m0tei/PressureTaps/mechanical/alt_press_fit/alt_closed_tube_side.png

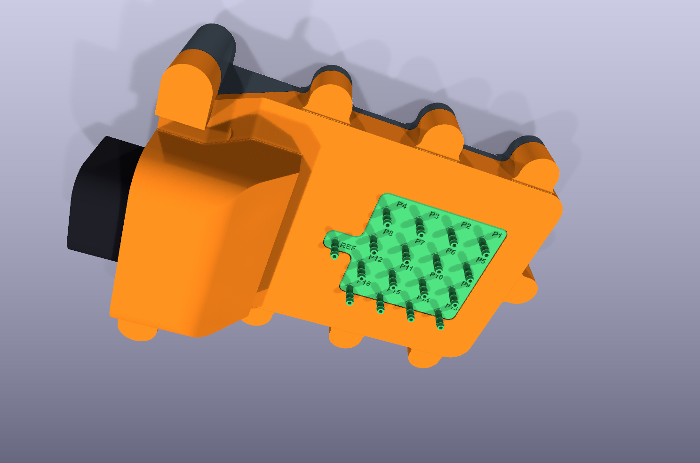
mechanical/alt_press_fit/alt_closed_tube_side.png
