m0tei/PressureTaps/mechanical/alt_press_fit/alt_module_top.png

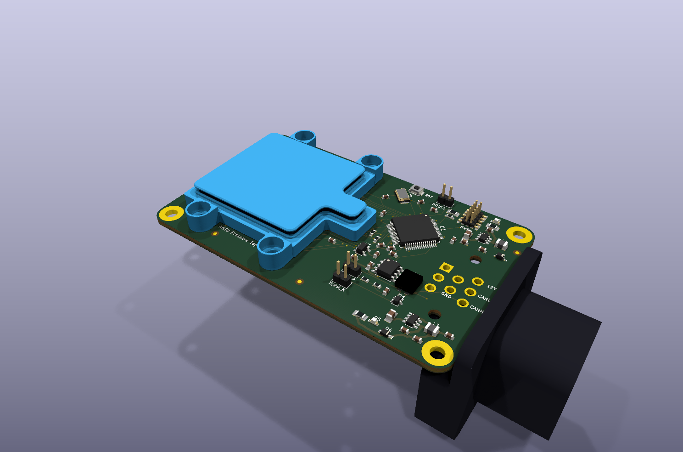
mechanical/alt_press_fit/alt_module_top.png
