m0tei/PressureTaps/mechanical/alt_press_fit/alt_closed.png

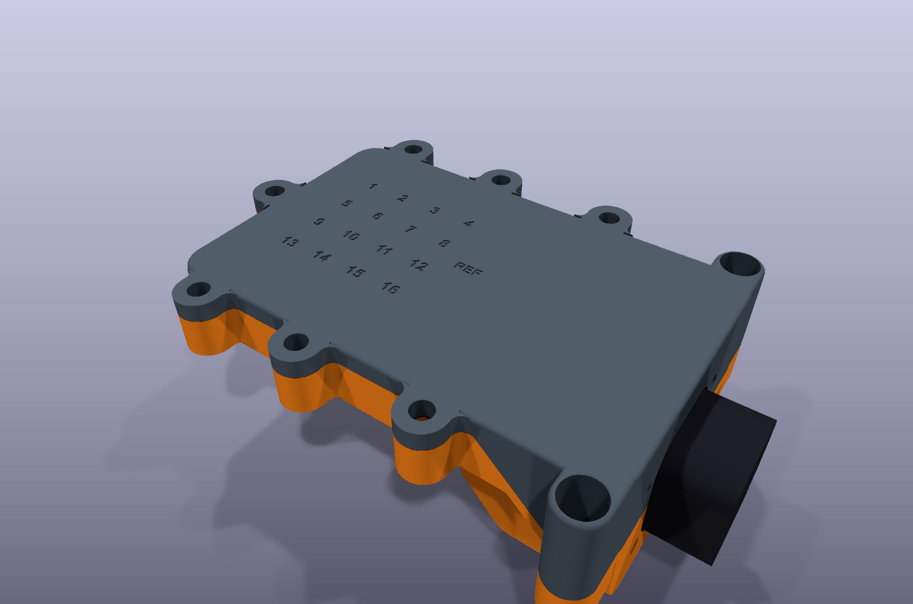
mechanical/alt_press_fit/alt_closed.png
