m0tei/PressureTaps/mechanical/alt_press_fit/alt_exploded.png

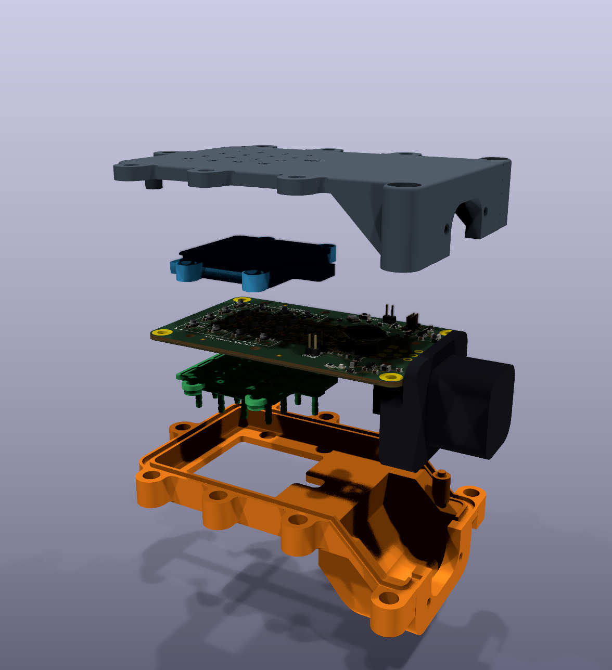
mechanical/alt_press_fit/alt_exploded.png
