m0tei/PressureTaps/mechanical/alt_press_fit/alt_exploded_underside.png

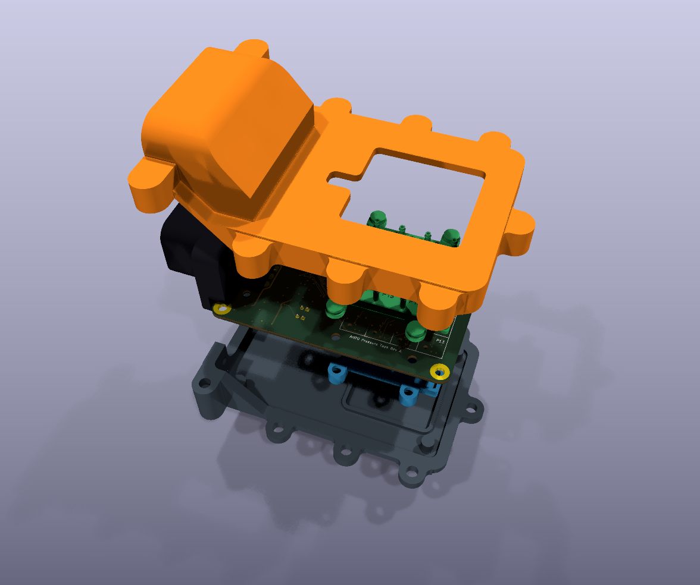
mechanical/alt_press_fit/alt_exploded_underside.png
