m0tei/PressureTaps/mechanical/alt_press_fit/alt_module_back.png

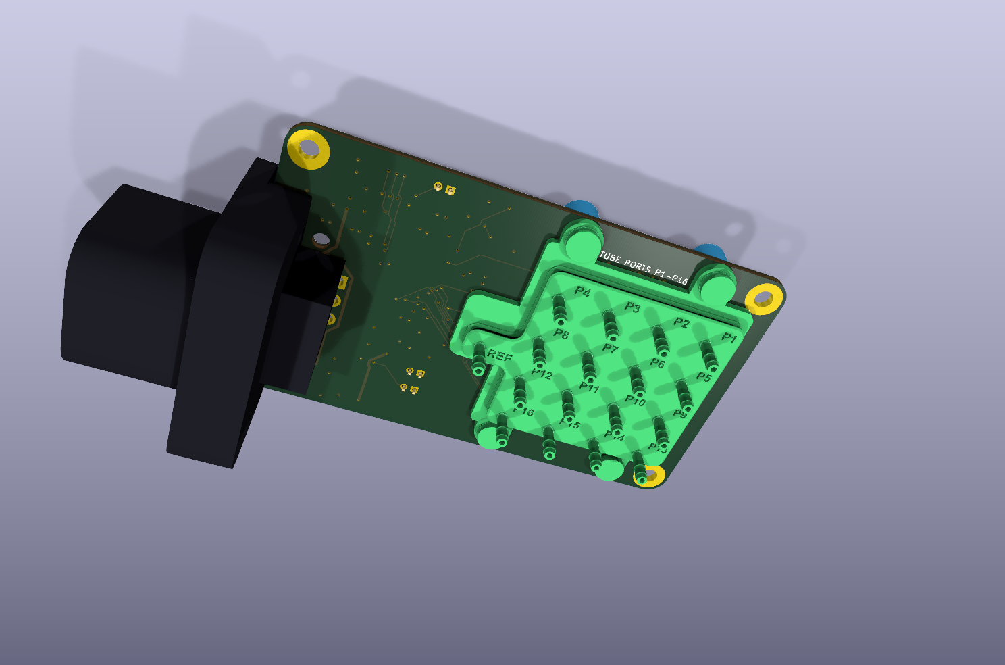
mechanical/alt_press_fit/alt_module_back.png
