m0tei/PressureTaps/mechanical/alt_press_fit/PressureTaps_Sensor_Cover.step

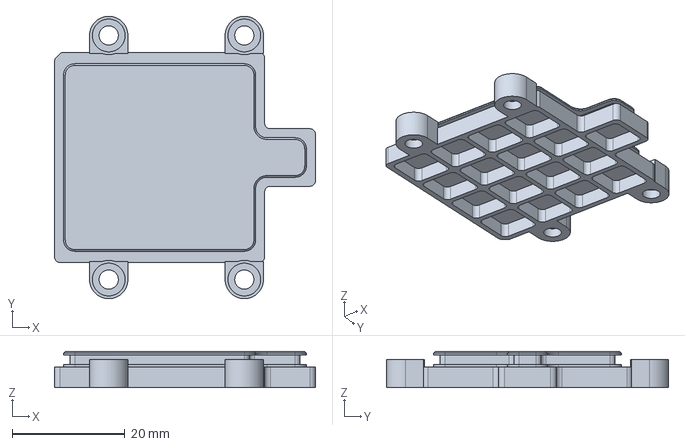
[picture p7: CAD file, 2026-11-06]
mechanical/alt_press_fit/PressureTaps_Sensor_Cover.step
46.2 x 50.0 x 6.40 mm
