m0tei/PressureTaps/mechanical/alt_press_fit/PressureTaps_Tube_Block.step

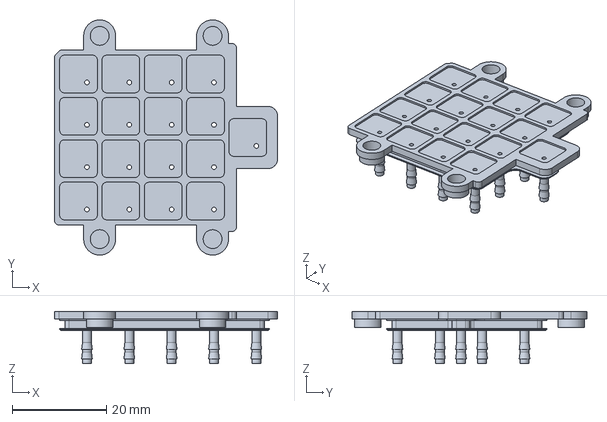
[picture p8: CAD file, 2026-11-06]
mechanical/alt_press_fit/PressureTaps_Tube_Block.step
47.4 x 50.0 x 11.1 mm
