m0tei/PressureTaps/mechanical/alt_press_fit/PressureTaps_Case_Bottom.step

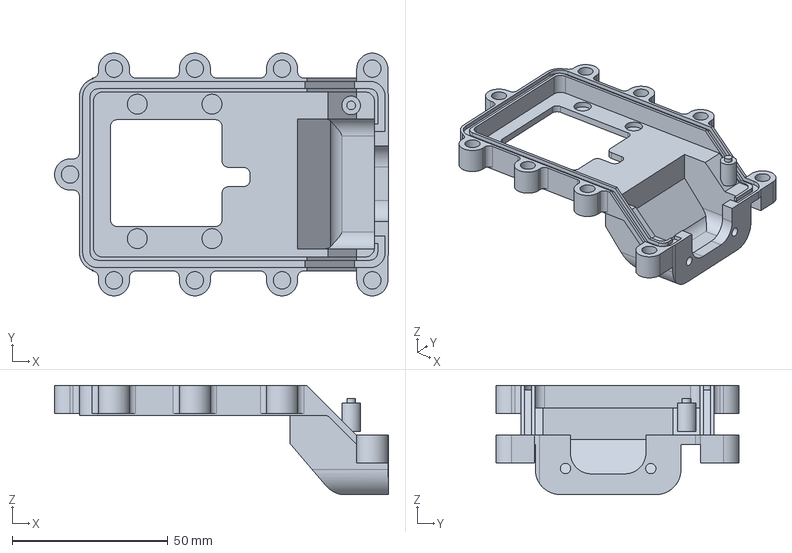
[picture p9: CAD file, 2026-11-06]
mechanical/alt_press_fit/PressureTaps_Case_Bottom.step
107.3 x 78.0 x 35.0 mm
