m0tei/PressureTaps/mechanical/alt_press_fit/PressureTaps_Case_Top.step

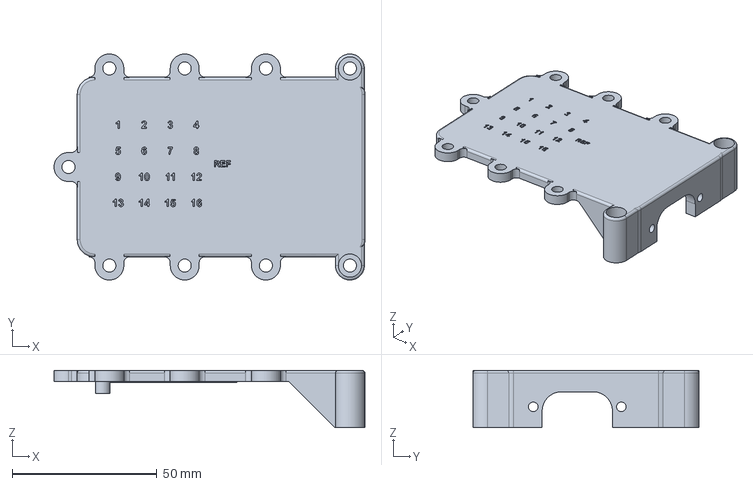
[picture p10: CAD file, 2026-11-06]
mechanical/alt_press_fit/PressureTaps_Case_Top.step
107.3 x 78.0 x 19.8 mm
