m0tei/PressureTaps/(list of files, cad)

Other CAD files:
mechanical/alt_press_fit/PressureTaps_Case_Bottom.stl
mechanical/alt_press_fit/PressureTaps_Case_Top.stl
mechanical/alt_press_fit/PressureTaps_Sensor_Cover.stl
mechanical/alt_press_fit/PressureTaps_Tube_Block.stl
