m0tei/PressureTaps/PressureTaps.kicad_pcb

## KiCad design PressureTaps.kicad_pcb (2026-11-06)

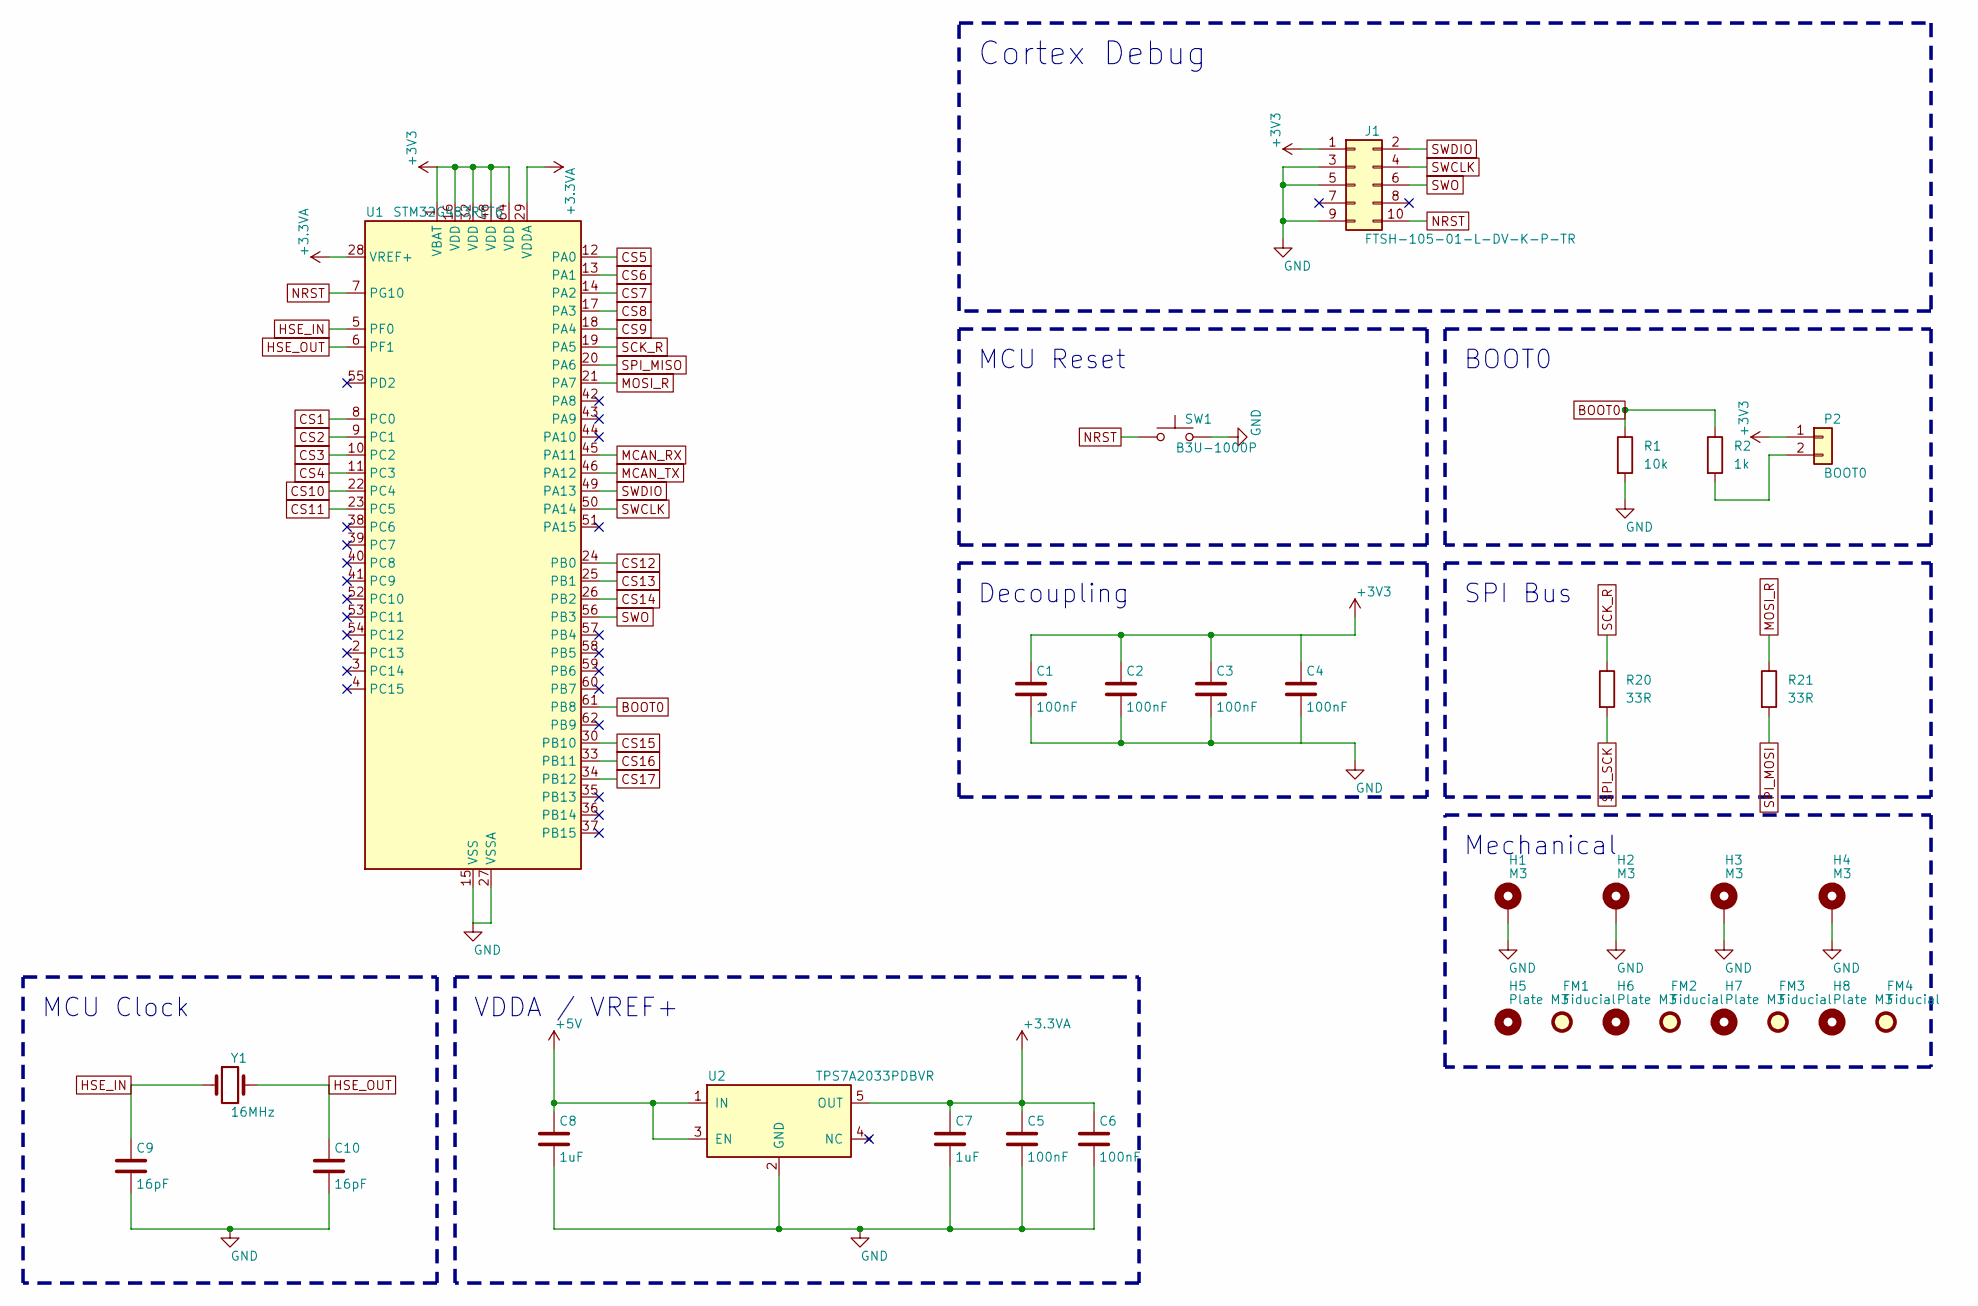
[picture p11: schematic MCU.kicad_sch]

Parts:
C1, C2, C3, C4, C5, C6: 100nF; GW_C1; MPN CC0603JRX7R9BB104
C7, C8: 1uF; GW_C7; MPN CC0603KRX5R8BB105
C9, C10: 16pF; GW_C9; MPN C0603C160J5HACTU
FM1, FM2, FM3, FM4: Fiducial; Fiducial_1mm_Mask2mm
H1, H2, H3, H4: M3; MountingHole_3.2mm_M3_Pad
H5, H6, H7, H8: Plate M3; MountingHole_3.2mm_M3
J1: FTSH-105-01-L-DV-K-P-TR; GW_J1; MPN FTSH-105-01-L-DV-K-P-TR
P2: BOOT0; PinHeader_1x02_P2.00mm_Vertical; MPN 62000211121
R1: 10k; GW_R1; MPN AF0603FR-0710KL
R2: 1k; GW_R2; MPN ERJ-6ENF1001V
R20, R21: 33R; GW_R1
SW1: B3U-1000P; SW_SPST_B3U-1000P; MPN B3U-1000P
U1: STM32G483RET6; LQFP-64_10x10mm_P0.5mm; MPN STM32G483RET6
U2: TPS7A2033PDBVR; SOT-23-5; MPN TPS7A2033PDBVR
Y1: 16MHz; GW_Y1; MPN ABM3-16.000MHZ-D2Y-T

Connections:
+3.3VA: C5.1, C6.1, C7.1, U1.28 (VREF+), U1.29 (VDDA), U2.5 (OUT)
+3V3: C1.1, C2.1, C3.1, C4.1, J1.1, P2.1, U1.1 (VBAT), U1.16 (VDD), U1.32 (VDD), U1.48 (VDD), U1.64 (VDD); also elsewhere on the board
+5V: C8.1, U2.1 (IN), U2.3 (EN); also elsewhere on the board
BOOT0: R1.1, R2.1, U1.61 (PB8)
CS1: U1.8 (PC0); also elsewhere on the board
CS2: U1.9 (PC1); also elsewhere on the board
CS3: U1.10 (PC2); also elsewhere on the board
CS4: U1.11 (PC3); also elsewhere on the board
CS5: U1.12 (PA0); also elsewhere on the board
CS6: U1.13 (PA1); also elsewhere on the board
CS7: U1.14 (PA2); also elsewhere on the board
CS8: U1.17 (PA3); also elsewhere on the board
CS9: U1.18 (PA4); also elsewhere on the board
CS10: U1.22 (PC4); also elsewhere on the board
CS11: U1.23 (PC5); also elsewhere on the board
CS12: U1.24 (PB0); also elsewhere on the board
CS13: U1.25 (PB1); also elsewhere on the board
CS14: U1.26 (PB2); also elsewhere on the board
CS15: U1.30 (PB10); also elsewhere on the board
CS16: U1.33 (PB11); also elsewhere on the board
CS17: U1.34 (PB12); also elsewhere on the board
GND: C1.2, C2.2, C3.2, C4.2, C5.2, C6.2, C7.2, C8.2, C9.2, C10.2, H1.1, H2.1, H3.1, H4.1, J1.3, J1.5, J1.9, R1.2, SW1.2, U1.15 (VSS), U1.27 (VSSA), U1.31 (VSS), U1.47 (VSS), U1.63 (VSS), U2.2 (GND); also elsewhere on the board
HSE_IN: C9.1, U1.5 (PF0), Y1.1
HSE_OUT: C10.1, U1.6 (PF1), Y1.2
MCAN_RX: U1.45 (PA11); also elsewhere on the board
MCAN_TX: U1.46 (PA12); also elsewhere on the board
MOSI_R: R21.1, U1.21 (PA7)
NRST: J1.10, SW1.1, U1.7 (PG10)
unnamed: P2.2, R2.2
SCK_R: R20.1, U1.19 (PA5)
SPI_MISO: U1.20 (PA6); also elsewhere on the board
SPI_MOSI: R21.2; also elsewhere on the board
SPI_SCK: R20.2; also elsewhere on the board
SWCLK: J1.4, U1.50 (PA14)
SWDIO: J1.2, U1.49 (PA13)
SWO: J1.6, U1.56 (PB3)

Notes on the sheet:
Cortex Debug
MCU Reset
BOOT0
Decoupling
SPI Bus
MCU Clock
VDDA / VREF+
Mechanical

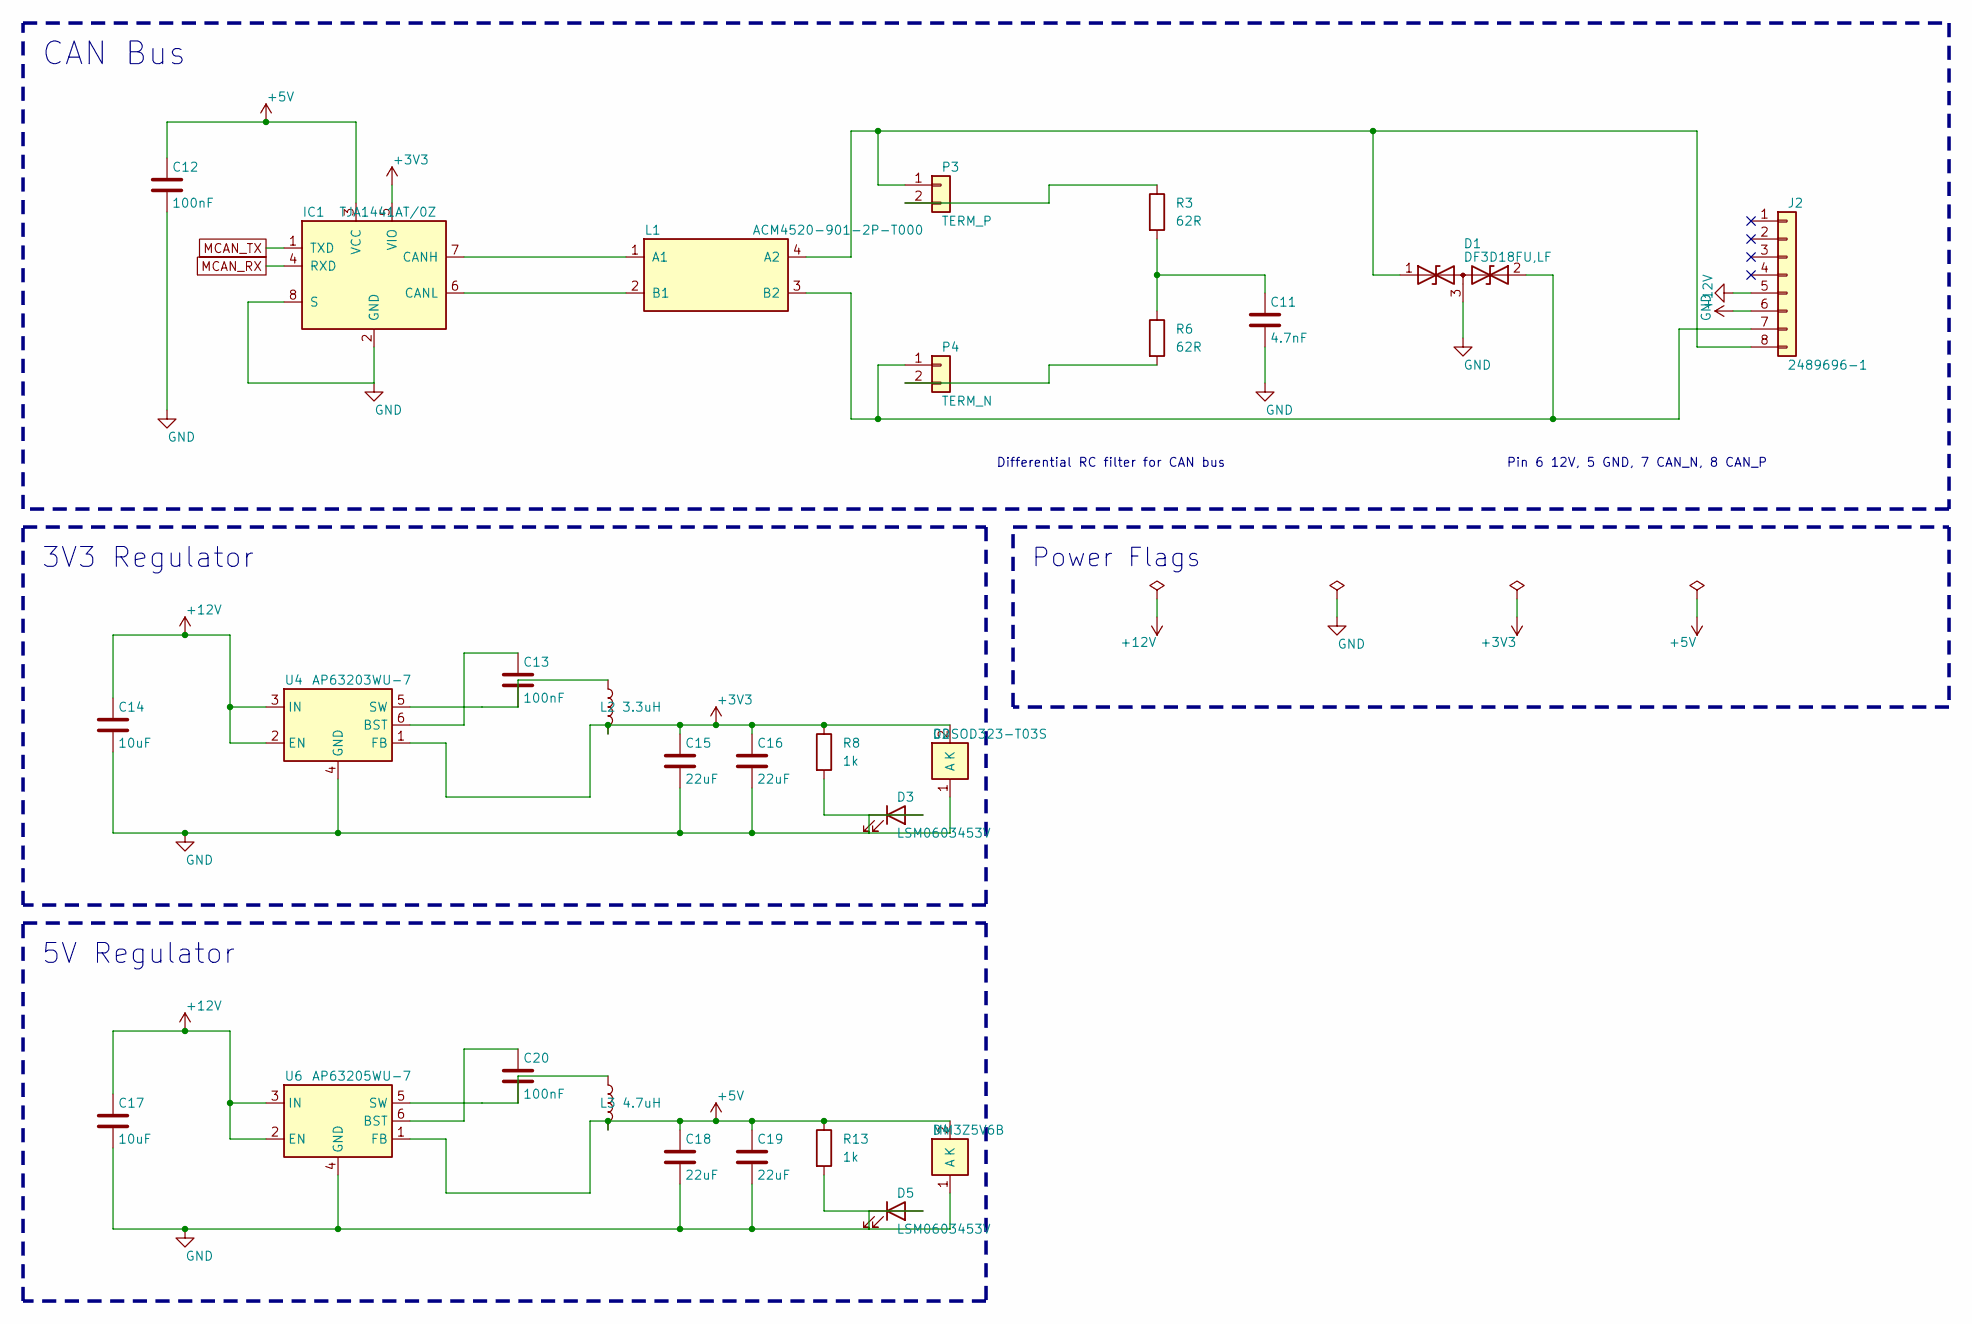
[picture p12: schematic Power_CAN.kicad_sch, Power + CAN]

Parts:
C11: 4.7nF; GW_C11; MPN C0603C472J5RACTU
C12: 100nF; GW_C12; MPN CC0603JRX7R9BB104
C13, C20: 100nF; GW_C7; MPN CC0603KRX7R8BB104
C14, C17: 10uF; GW_C14; MPN CL21A106KAYNNNE
C15, C16, C18, C19: 22uF; GW_C15; MPN GRM188R61A226ME15D
D1: DF3D18FU,LF; SOT-323_SC-70; MPN DF3D18FU,LF
D2: CDSOD323-T03S; GW_D2; MPN CDSOD323-T03S
D3, D5: LSM0603453V; GW_D3; MPN LSM0603453V
D4: MM3Z5V6B; GW_D4; MPN MM3Z5V6B
IC1: TJA1441AT/0Z; SOIC-8_3.9x4.9mm_P1.27mm; MPN TJA1441AT/0Z
J2: 2489696-1; Ampseal_8P_90deg; MPN 2489696-1
L1: ACM4520-901-2P-T000; L_ACM4520; MPN ACM4520-901-2P-T000
L2: 3.3uH; GW_L2; MPN DFE252012P-3R3M=P2
L3: 4.7uH; GW_L3; MPN DFE252012F-4R7M=P2
P3: TERM_P; PinHeader_1x02_P2.00mm_Vertical; MPN 62000211121
P4: TERM_N; PinHeader_1x02_P2.00mm_Vertical; MPN 62000211121
R3, R6: 62R; GW_R3; MPN ERA3AEB620V
R8, R13: 1k; GW_R8; MPN ERJ-6ENF1001V
U4: AP63203WU-7; TSOT-23-6; MPN AP63203WU-7
U6: AP63205WU-7; TSOT-23-6; MPN AP63205WU-7

Connections:
+3V3: C15.1, C16.1, D2.2 (K), IC1.5 (VIO), L2.2, R8.1, U4.1 (FB); also elsewhere on the board
+5V: C12.1, C18.1, C19.1, D4.2 (K), IC1.3 (VCC), L3.2, R13.1, U6.1 (FB); also elsewhere on the board
+12V: C14.1, C17.1, J2.6, U4.2 (EN), U4.3 (IN), U6.2 (EN), U6.3 (IN)
GND: C11.2, C12.2, C14.2, C15.2, C16.2, C17.2, C18.2, C19.2, D1.3 (common), D2.1 (A), D3.1 (K), D4.1 (A), D5.1 (K), IC1.2 (GND), IC1.8 (S), J2.5, U4.4 (GND), U6.4 (GND); also elsewhere on the board
MCAN_RX: IC1.4 (RXD); also elsewhere on the board
MCAN_TX: IC1.1 (TXD); also elsewhere on the board
unnamed: C11.1, R3.2, R6.1
unnamed: D1.1 (A1), J2.8, L1.4 (A2), P3.1
unnamed: D1.2 (A2), J2.7, L1.3 (B2), P4.1
unnamed: D3.2 (A), R8.2
unnamed: D5.2 (A), R13.2
unnamed: IC1.7 (CANH), L1.1 (A1)
unnamed: IC1.6 (CANL), L1.2 (B1)
unnamed: P3.2, R3.1
unnamed: P4.2, R6.2
unnamed: C13.1, U4.6 (BST)
unnamed: C13.2, L2.1, U4.5 (SW)
unnamed: C20.1, U6.6 (BST)
unnamed: C20.2, L3.1, U6.5 (SW)

Notes on the sheet:
CAN Bus
Differential RC filter for CAN bus
3V3 Regulator
5V Regulator
Power Flags
Pin 6 12V, 5 GND, 7 CAN_N, 8 CAN_P

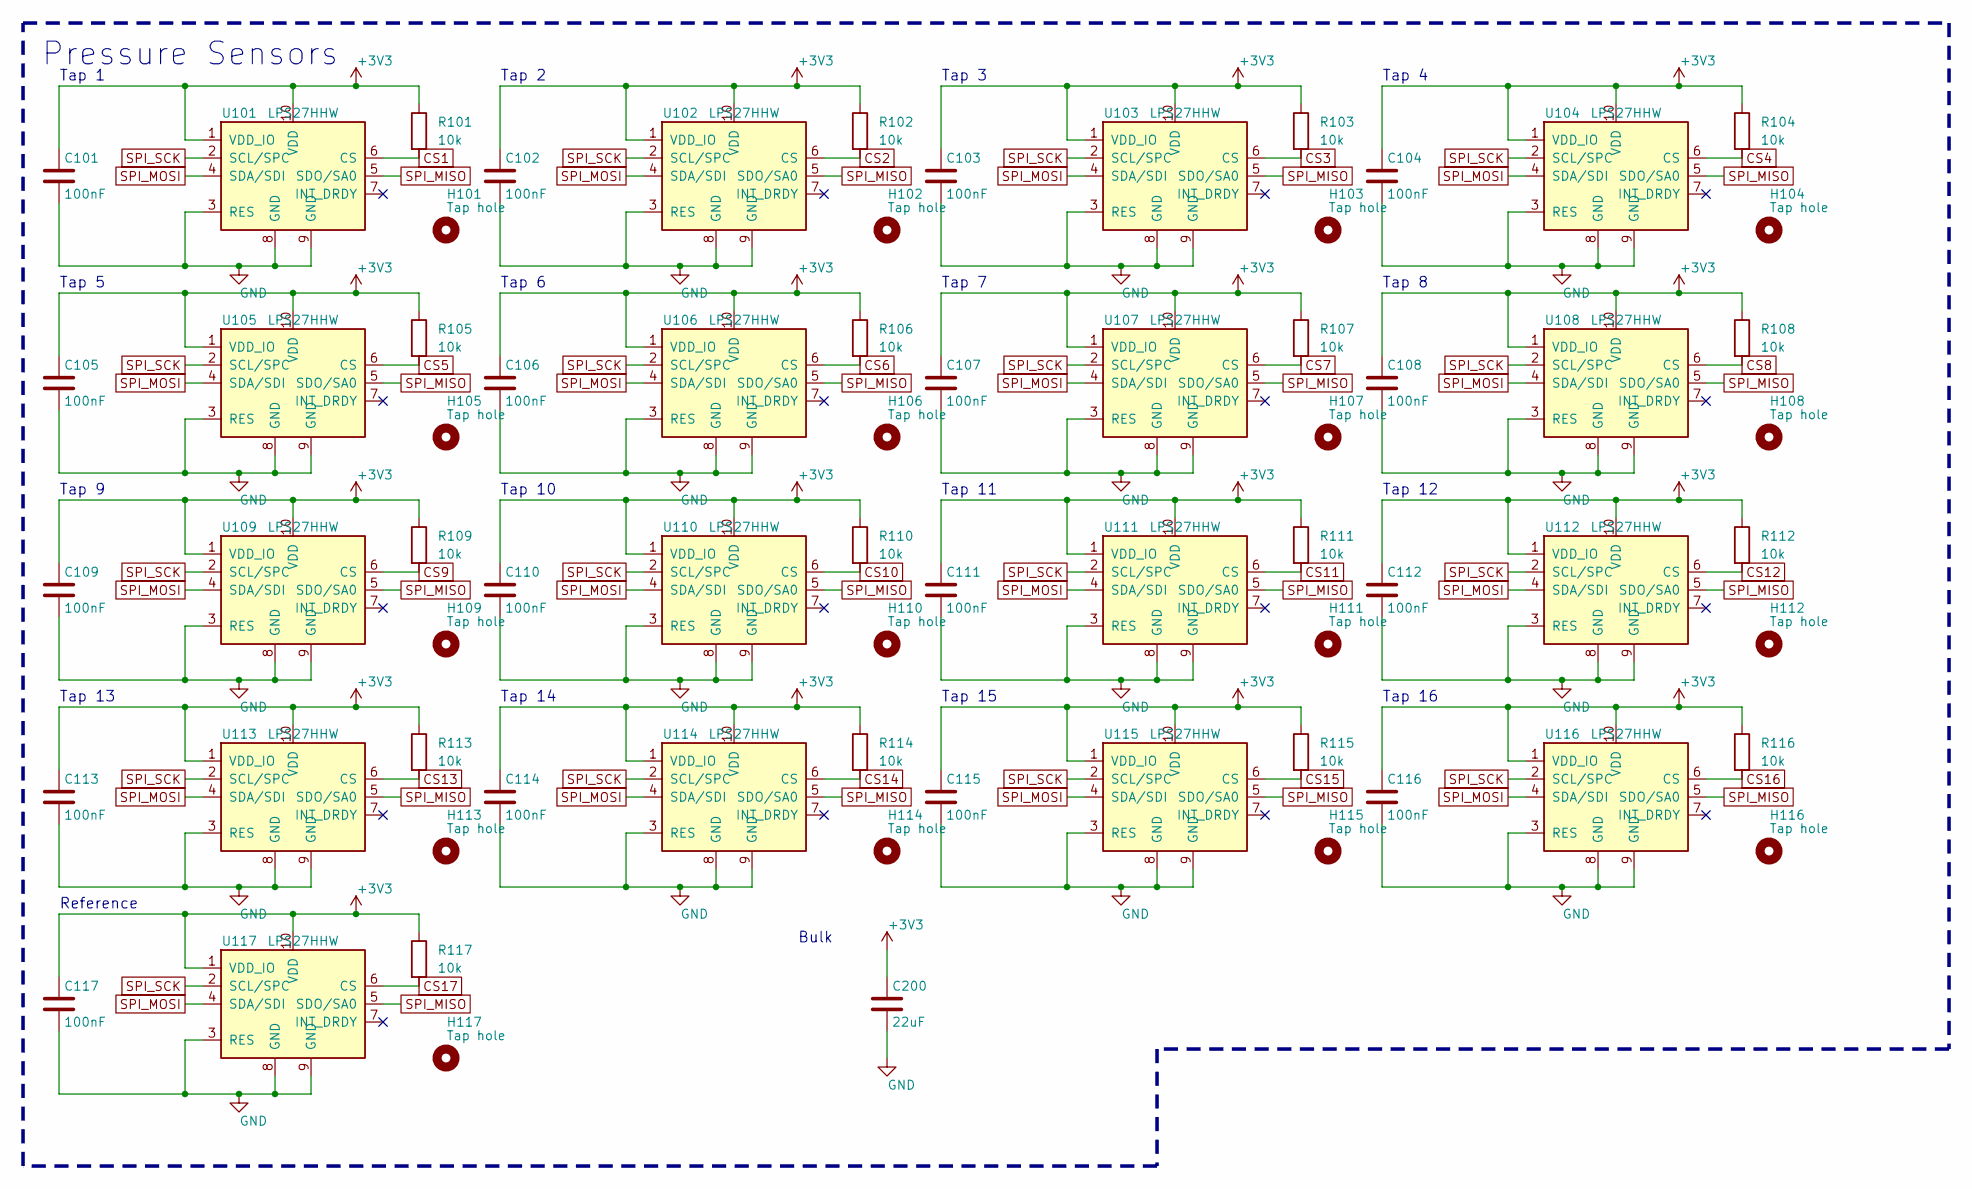
[picture p13: schematic Sensors.kicad_sch, Pressure sensors]

Parts:
C101, C102, C103, C104, C105, C106, C107, C108, C109, C110, C111, C112, C113, C114, C115, C116, C117: 100nF; GW_C1; MPN CC0603JRX7R9BB104
C200: 22uF; GW_C15; MPN GRM188R61A226ME15D
H101, H102, H103, H104, H105, H106, H107, H108, H109, H110, H111, H112, H113, H114, H115, H116, H117: Tap hole; TapHole_1.5mm
R101, R102, R103, R104, R105, R106, R107, R108, R109, R110, R111, R112, R113, R114, R115, R116, R117: 10k; GW_R1; MPN AF0603FR-0710KL
U101, U102, U103, U104, U105, U106, U107, U108, U109, U110, U111, U112, U113, U114, U115, U116, U117: LPS27HHW; MPN LPS27HHWTR

Connections:
+3V3: C101.1, C102.1, C103.1, C104.1, C105.1, C106.1, C107.1, C108.1, C109.1, C110.1, C111.1, C112.1, C113.1, C114.1, C115.1, C116.1, C117.1, C200.1, R101.1, R102.1, R103.1, R104.1, R105.1, R106.1, R107.1, R108.1, R109.1, R110.1, R111.1, R112.1, R113.1, R114.1, R115.1, R116.1, R117.1, U101.1 (VDD_IO), U101.10 (VDD), U102.1 (VDD_IO), U102.10 (VDD), U103.1 (VDD_IO), U103.10 (VDD), U104.1 (VDD_IO), U104.10 (VDD), U105.1 (VDD_IO), U105.10 (VDD), U106.1 (VDD_IO), U106.10 (VDD), U107.1 (VDD_IO), U107.10 (VDD), U108.1 (VDD_IO), U108.10 (VDD), U109.1 (VDD_IO), U109.10 (VDD), U110.1 (VDD_IO), U110.10 (VDD), U111.1 (VDD_IO), U111.10 (VDD), U112.1 (VDD_IO), U112.10 (VDD), U113.1 (VDD_IO), U113.10 (VDD), U114.1 (VDD_IO), U114.10 (VDD), U115.1 (VDD_IO), U115.10 (VDD), U116.1 (VDD_IO), U116.10 (VDD), U117.1 (VDD_IO), U117.10 (VDD); also elsewhere on the board
CS1: R101.2, U101.6 (CS); also elsewhere on the board
CS2: R102.2, U102.6 (CS); also elsewhere on the board
CS3: R103.2, U103.6 (CS); also elsewhere on the board
CS4: R104.2, U104.6 (CS); also elsewhere on the board
CS5: R105.2, U105.6 (CS); also elsewhere on the board
CS6: R106.2, U106.6 (CS); also elsewhere on the board
CS7: R107.2, U107.6 (CS); also elsewhere on the board
CS8: R108.2, U108.6 (CS); also elsewhere on the board
CS9: R109.2, U109.6 (CS); also elsewhere on the board
CS10: R110.2, U110.6 (CS); also elsewhere on the board
CS11: R111.2, U111.6 (CS); also elsewhere on the board
CS12: R112.2, U112.6 (CS); also elsewhere on the board
CS13: R113.2, U113.6 (CS); also elsewhere on the board
CS14: R114.2, U114.6 (CS); also elsewhere on the board
CS15: R115.2, U115.6 (CS); also elsewhere on the board
CS16: R116.2, U116.6 (CS); also elsewhere on the board
CS17: R117.2, U117.6 (CS); also elsewhere on the board
GND: C101.2, C102.2, C103.2, C104.2, C105.2, C106.2, C107.2, C108.2, C109.2, C110.2, C111.2, C112.2, C113.2, C114.2, C115.2, C116.2, C117.2, C200.2, U101.3 (RES), U101.8 (GND), U101.9 (GND), U102.3 (RES), U102.8 (GND), U102.9 (GND), U103.3 (RES), U103.8 (GND), U103.9 (GND), U104.3 (RES), U104.8 (GND), U104.9 (GND), U105.3 (RES), U105.8 (GND), U105.9 (GND), U106.3 (RES), U106.8 (GND), U106.9 (GND), U107.3 (RES), U107.8 (GND), U107.9 (GND), U108.3 (RES), U108.8 (GND), U108.9 (GND), U109.3 (RES), U109.8 (GND), U109.9 (GND), U110.3 (RES), U110.8 (GND), U110.9 (GND), U111.3 (RES), U111.8 (GND), U111.9 (GND), U112.3 (RES), U112.8 (GND), U112.9 (GND), U113.3 (RES), U113.8 (GND), U113.9 (GND), U114.3 (RES), U114.8 (GND), U114.9 (GND), U115.3 (RES), U115.8 (GND), U115.9 (GND), U116.3 (RES), U116.8 (GND), U116.9 (GND), U117.3 (RES), U117.8 (GND), U117.9 (GND); also elsewhere on the board
SPI_MISO: U101.5 (SDO/SA0), U102.5 (SDO/SA0), U103.5 (SDO/SA0), U104.5 (SDO/SA0), U105.5 (SDO/SA0), U106.5 (SDO/SA0), U107.5 (SDO/SA0), U108.5 (SDO/SA0), U109.5 (SDO/SA0), U110.5 (SDO/SA0), U111.5 (SDO/SA0), U112.5 (SDO/SA0), U113.5 (SDO/SA0), U114.5 (SDO/SA0), U115.5 (SDO/SA0), U116.5 (SDO/SA0), U117.5 (SDO/SA0); also elsewhere on the board
SPI_MOSI: U101.4 (SDA/SDI), U102.4 (SDA/SDI), U103.4 (SDA/SDI), U104.4 (SDA/SDI), U105.4 (SDA/SDI), U106.4 (SDA/SDI), U107.4 (SDA/SDI), U108.4 (SDA/SDI), U109.4 (SDA/SDI), U110.4 (SDA/SDI), U111.4 (SDA/SDI), U112.4 (SDA/SDI), U113.4 (SDA/SDI), U114.4 (SDA/SDI), U115.4 (SDA/SDI), U116.4 (SDA/SDI), U117.4 (SDA/SDI); also elsewhere on the board
SPI_SCK: U101.2 (SCL/SPC), U102.2 (SCL/SPC), U103.2 (SCL/SPC), U104.2 (SCL/SPC), U105.2 (SCL/SPC), U106.2 (SCL/SPC), U107.2 (SCL/SPC), U108.2 (SCL/SPC), U109.2 (SCL/SPC), U110.2 (SCL/SPC), U111.2 (SCL/SPC), U112.2 (SCL/SPC), U113.2 (SCL/SPC), U114.2 (SCL/SPC), U115.2 (SCL/SPC), U116.2 (SCL/SPC), U117.2 (SCL/SPC); also elsewhere on the board

Notes on the sheet:
Pressure Sensors
Tap 1
Tap 2
Tap 3
Tap 4
Tap 5
Tap 6
Tap 7
Tap 8
Tap 9
Tap 10
Tap 11
Tap 12
Tap 13
Tap 14
Tap 15
Tap 16
Reference
Bulk

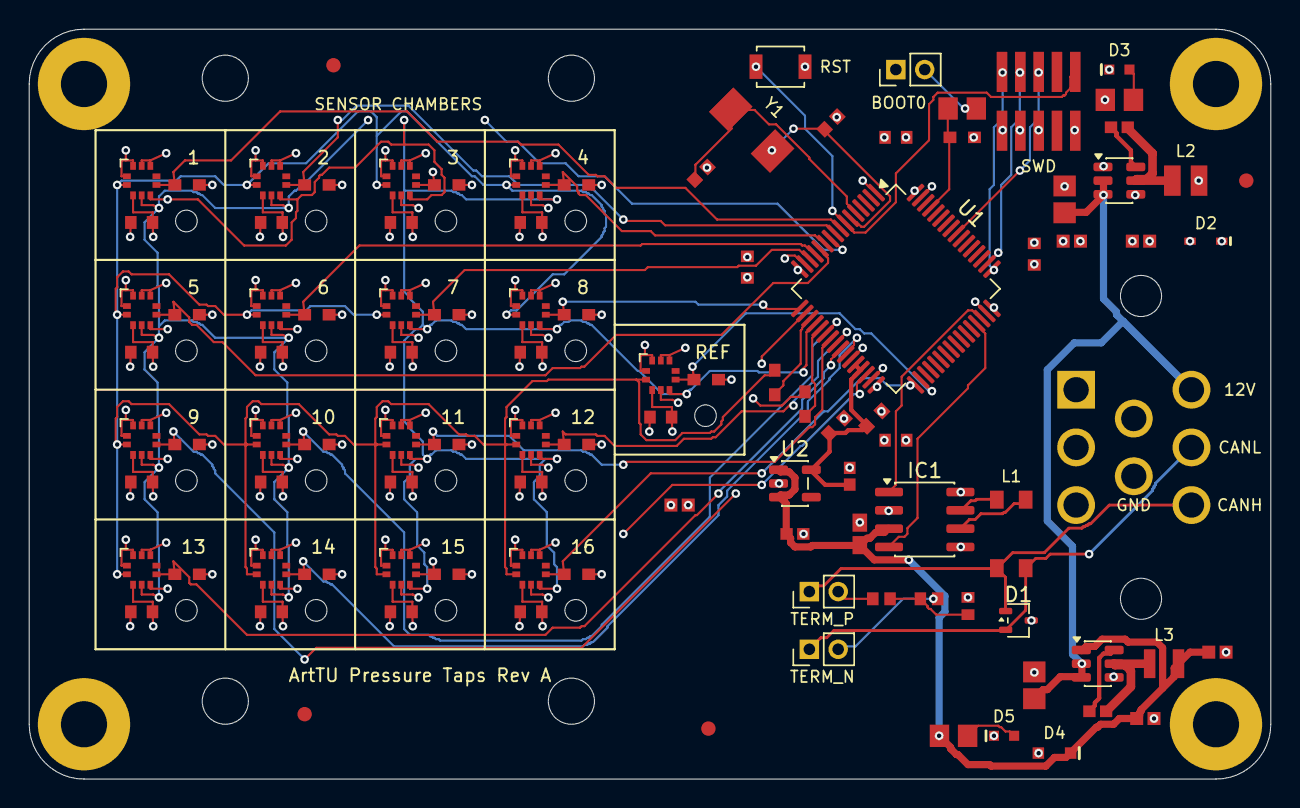
[picture p14: board PressureTaps.kicad_pcb from above]

Board: 4 copper layers, 86.1 x 52.0 mm, 129 parts (1 on the bottom side), 50 nets.
