m0tei/PressureTaps/(commit log)

2026-11-04 Add PressureTaps KiCad project
    [MCU.kicad_sch, Power_CAN.kicad_sch, PressureTaps.kicad_pcb, PressureTaps.kicad_sch, Sensors.kicad_sch]
2026-11-05 Finish board layout and add press-fit enclosure
    Board
    - Compact to 86 x 52 mm and move the Ampseal to the short edge, on the
    back of the PCB, which corrects its pin order
    - Route the board, with wider power and CAN tracks
    - Move H6 and H8 so the cover tabs sit inside the cover outline
    - Add gateway footprints, part numbers and sensor and L1 3D models
    Enclosure (mechanical/alt_press_fit)
    - Sensor cover and tube block glue to the PCB as a separate module
    - Module presses into the case, sealed by silicone cord on both sides
    - Case closes with M4 screws around a sloped seam; the Ampseal mounts
    through the end wall on its own gasket
    [MCU.kicad_sch, Power_CAN.kicad_sch, PressureTaps.kicad_pcb, PressureTaps.kicad_sch, PressureTaps_Case_Bottom.step, PressureTaps_Case_Bottom.stl, PressureTaps_Case_Top.step, PressureTaps_Case_Top.stl]
2026-11-06 Make sensor cover and tube block glue faces flat
    [PressureTaps_Sensor_Cover.step, PressureTaps_Sensor_Cover.stl, PressureTaps_Tube_Block.step, PressureTaps_Tube_Block.stl]
